farrismh/Self-Stabilizing_Gimbal_Joysticks/(commit log)

2025-11-17 Add Gimbal Joystick control with IMU and servos
2025-11-17 Implement real-time data processing and Kalman filtering
    This script reads real-time data from an Arduino, applies a Kalman filter for postprocessing, and provides options to visualize and save the results.
2025-11-17 Add project overview and background to README
    Added detailed project description and background information for the dual-joystick gimbal system, including its objectives, challenges, and integration of IMU with Kalman Filtering for stabilization.
